mcer12/Nick2-Nixie-Clock/Resources/Nick2_in12_BOM.csv

ID | Name | Designator | Footprint | Quantity | Manufacturer Part | Manufacturer | Supplier | Supplier Part | Price
1 | 100nF | C1,C4,C5,C6,C7,C8,C9 | C0603 | 7 | CC0603KRX7R9BB104 | YAGEO | LCSC | C14663
2 | 10uF | C2 | C0603 | 1 | CL10A106KP8NNNC | SAMSUNG | LCSC | C19702 | 0.001
3 | 470uF | C10 | CAP-SMD_L7.3-W4.3-R-RD | 1 | T491D477M006AT | KEMET | LCSC | C122309 | 0.14
4 | ESP-WROOM-32 | ESP | WIFIM-SMD_ESP-WROOM-32 | 1 | ESP-WROOM-32 | ESPRESSIF | LCSC | C95209
5 | MF-PSMF110X-2 | F2 | F0805 | 1 | MF-PSMF110X-2 | BOURNS | LCSC | C89658 | 0.004
6 | AMS1117-3.3 | U6 | SOT-223-3_L6.5-W3.4-P2.30-LS7.0-BR | 1 | AMS1117-3.3 | AMS | LCSC | C6186 | 0.024
7 | U-D-M5DD-W-1 | USB1 | MICRO-USB-TH_MICRO-USB-A14 | 1 | U-D-M5DD-W-1 | HRO | LCSC | C145795 | 0.029
8 | WS2812B | LED1,LED2,LED3,LED4,LED5 | LED-SMD_4P-L5.0-W5.0-TL | 5 | WS2812B | Worldsemi | LCSC | C114585
9 | SW_IN-12B | NIX1,NIX2,NIX3,NIX4 | PK_IN-12B | 4
10 | MMBTA42_C118745 | NPN1,NPN2,NPN3,NPN4 | SOT-23-3_L2.9-W1.3-P1.90-LS2.4-BR | 4 | MMBTA42 | SEMTECH | LCSC | C118745 | 0.005
11 | MMBTA92-C118746 | PNP1,PNP2,PNP3,PNP4 | SOT-23-3_L2.9-W1.3-P1.90-LS2.4-BR | 4 | MMBTA92 | SEMTECH | LCSC | C118746 | 0.005
12 | 200K | R1,R3,R4,R5,R10,R11,R17,R18 | R1206 | 8 | TC0625D2003T5E | Uniroyal Elec | LCSC | C56009 | 0.007
13 | 4.7K | R2,R7,R8,R20 | R0603 | 4 | 0603WAF4701T5E | UniOhm | LCSC | C23162
14 | 470K | R6,R9,R12,R19 | R1206 | 4 | 1206W4F4703T5E | UniOhm | LCSC | C17997 | 0.001
15 | 1K | R13,R14 | R0603 | 2 | 0603WAF1001T5E | UniOhm | LCSC | C21190
16 | 10K | R15,R16,R31 | R0603 | 3 | 0603WAF1002T5E | UniOhm | LCSC | C25804
17 | 4.7K | R23,R24,R25,R26,R27,R28,R29,R30 | R1206 | 8 | 1206W4J0472T5E | UniOhm | LCSC | C26043
18 | MMBT3904-C20526 | T3,T4 | SOT-23-3_L2.9-W1.3-P1.90-LS2.4-BR | 2 | MMBT3904 | CJ | LCSC | C20526 | 0.002
19 | USBLC6-2SC6_C323793 | U1 | SOT-23-6_L2.9-W1.6-P0.95-LS2.8-BL | 1 | USBLC6-2SC6 | Yenji Elec | LCSC | C323793 | 0.013
20 | NCH8200HV | U2 | NCH8200HV | 1 | New SchematicLib |  | NixieClock | NCH8200HV
21 | 74141 Decoder | U3 | PDIP-16_L19.7-W6.6-P2.54-LS10.9-BL | 1 | CD4015BE | Texas Instruments |  | C201208 | 0.064
22 | CH340C | U5 | SOP-16_L10.0-W3.9-P1.27-LS6.0-BL | 1 | CH340C | WCH | LCSC | C84681 | 0.075
