mcer12/Nick2-Nixie-Clock/Resources/Nick2_in16_BOM.csv

ID | Name | Designator | Footprint | Quantity | Manufacturer Part | Manufacturer | Supplier | Supplier Part | Price
1 | 100nF | C1,C3,C4,C12,C13,C14,C15,C22 | C0603 | 8 | CC0603KRX7R9BB104 | YAGEO | LCSC | C14663
2 | 10uF | C2,C11 | C0603 | 2 | CL10A106KP8NNNC | SAMSUNG | LCSC | C19702 | 0.001
3 | 22uF | C6 | C0603 | 1 | CL10A226MQ8NRNC | SAMSUNG | LCSC | C59461 | 0.001
4 | 220pF | C7 | C0603 | 1 | CL10B221KB8NNNC | SAMSUNG | LCSC | C1603 | 0.001
5 | 1uF | C8 | C1812 | 1 | FS43X105K251EGG | Prosperity Dielectrics | LCSC | C381468 | 0.014
6 | 1uF | C9 | C0603 | 1 | CL10A105KB8NNNC | SAMSUNG | LCSC | C15849 | 0.001
7 | 220nF | C10 | C0603 | 1 | CL10B224KA8NNNC | SAMSUNG | LCSC | C21120 | 0.001
8 | MM1W91 | D2 | SOD-123FL_L2.7-W1.8-LS3.8-RD | 1 | MM1W91 | (MDD) Jiangsu Yutai Elec | LCSC | C364305 | 0.007
9 | DSF1G E1G | D3 | SOD-123_L2.8-W1.8-LS3.7-RD | 1 | DSF1G E1G | MDD | LCSC | C64910 | 0.002
10 | ESP-M2 | ESP | ESP-M2 | 1 | ESP-M2 | Ai-Thinker |  | C82895 | 0.364
11 | BSS138 | F2 | SOT-23-3_L2.9-W1.3-P1.90-LS2.4-BR | 1 | BSS138 | CJ | LCSC | C78284 | 0.004
12 | MF-PSMF110X-2 | F5 | F0805 | 1 | MF-PSMF110X-2 | BOURNS | LCSC | C89658 | 0.004
13 | AP7361-33E-13 | LDO1 | SOT-223_L6.5-W3.5-P2.30-LS7.0-BR | 1 | AP7361-33E-13 | DIODES | LCSC | C150719 | 0.023
14 | WS2812B | LED1,LED2,LED3,LED4,LED5,LED6,LED7,LED8,LED9,LED10,LED11,LED12,LED13,LED14 | LED-SMD_4P-L5.0-W5.0-TL | 14 | WS2812B | Worldsemi | LCSC | C114585
15 | IN-16 COPY | N1,N2,N3,N4,N5,N6 | IN-16 | 6 | IN-14
16 | ASDM30N65E | Q1 | DFN-8_L3.3-W3.3-P0.65-BL-EP | 1 | ASDM30N65E | Ascend(安森德) | LCSC | C2758222 | 0.052
17 | 20kΩ | R1,R2,R8,R9,R10,R11 | R1206 | 6 | 1206W4J0203T5E | UniOhm | LCSC | C25652
18 | 10K | R3,R4,R6 | R0603 | 3 | 0603WAF1002T5E | UniOhm | LCSC | C25804
19 | 1K | R5,R7,R25 | R0603 | 3 | 0603WAF1001T5E | UniOhm | LCSC | C21190
20 | 10MΩ | R12 | R1206 | 1 | HV06W4J0106T5E | UNI-ROYAL(Uniroyal Elec) | LCSC | C414767 | 0.003
21 | 470kΩ | R13 | R1210 | 1 | 1210W2J0474T5E | UNI-ROYAL(Uniroyal Elec) | LCSC | C621047 | 0.001
22 | 7.5kΩ | R15 | R0603 | 1 | 0603WAJ0752T5E | UniOhm | LCSC | C26006
23 | 499kΩ | R16 | R0603 | 1 | 0603WAF4993T5E | UniOhm | LCSC | C26751
24 | 5.1K | R18,R19 | R0603 | 2 | 0603WAF5101T5E | UniOhm | LCSC | C23186
25 | 10mΩ | R20 | R1206 | 1 | 1206W3F100MT5E | UNI-ROYAL(Uniroyal Elec) | LCSC | C473031 | 0.004
26 | 68kΩ | R21 | R0603 | 1 | 0603WAF6802T5E | UniOhm | LCSC | C23231
27 | MMBT3904-C20526 | T1,T2 | SOT-23-3_L2.9-W1.3-P1.90-LS2.4-BR | 2 | MMBT3904 | CJ | LCSC | C20526 | 0.002
28 | EE5.0 | T3 | EE5.0 | 1
29 | TTRN-060S-013 | T4 | TTRN-060S-013 | 1
30 | SN75468D | U1,U2,U3,U7,U8,U9,U10,U11,U12 | SOIC-16_L9.9-W3.9-P1.27-LS6.0-BL | 9 | SN75468D | TI(德州仪器) | LCSC | C2867467 | 0.097
31 | MAX668EUB+_C1530054 | U4 | UMAX-10_L3.0-W3.0-P0.50-LS4.9-BL | 1 | MAX668EUB+ | MAXIM(美信) | LCSC | C1530054 | 1.768
32 | 74HCT595PW-Q100,11 | U5,U13,U14,U15,U16,U17,U18,U19 | TSSOP-16_L5.0-W4.4-P0.65-LS6.4-BL | 8 | 74HCT595PW-Q100,11 | Nexperia | LCSC | C179330 | 0.052
33 | USBLC6-2SC6_C323793 | U6 | SOT-23-6_L2.9-W1.6-P0.95-LS2.8-BL | 1 | USBLC6-2SC6 | Yenji Elec | LCSC | C323793 | 0.013
34 | CH340C | U20 | SOP-16_L10.0-W3.9-P1.27-LS6.0-BL | 1 | CH340C | WCH | LCSC | C84681 | 0.075
35 | USB3.1C16PFSMT | USBC1 | USB-C-SMD_TYPE-C-USB-17 | 1 | - | LCSC | LCSC | C167321 | 0.055
