mcer12/Nick2-Nixie-Clock/Resources/Nick2_ZM1040_BOM.csv

ID | Name | Designator | Footprint | Quantity | Manufacturer Part | Manufacturer | Supplier | Supplier Part | Price
1 | 100nF | C6,C1,C3,C4,C12,C13,C14,C22 | C0603 | 8 | CC0603KRX7R9BB104 | YAGEO | LCSC | C14663
2 | 330Ω | R61 | R0603 | 1 | 0603WAF3300T5E | UniOhm | LCSC | C23138
3 | 1K | R41,R42,R43,R44,R45,R46,R47,R48,R49,R50,R51,R52,R53,R54,R55,R56,R57,R58,R59,R60,R11,R22,R23,R24,R25,R26,R27,R28,R29,R30,R31,R32,R33,R34,R35,R36,R37,R38,R39,R40,R5,R7,R10 | R0603 | 43 | 0603WAF1001T5E | UniOhm | LCSC | C21190
4 | 22uF | C15 | C1206 | 1 | CL31A226KPHNNNE | SAMSUNG(三星) | LCSC | C5672 | 0.004
5 | 10uF | C2,C11 | C0603 | 2 | CL10A106KP8NNNC | SAMSUNG | LCSC | C19702 | 0.001
6 | 1uF | C5,C8 | C1812 | 2 | FS43X105K251EGG | Prosperity Dielectrics | LCSC | C381468 | 0.015
7 | 220pF | C7 | C0603 | 1 | CL10B221KB8NNNC | SAMSUNG | LCSC | C1603 | 0.001
8 | 1uF | C9 | C0603 | 1 | CL10A105KB8NNNC | SAMSUNG | LCSC | C15849 | 0.001
9 | 220nF | C10 | C0603 | 1 | CL10B224KA8NNNC | SAMSUNG | LCSC | C21120 | 0.001
10 | DSF1G E1G | D3 | SOD-123_L2.8-W1.8-LS3.7-RD | 1 | DSF1G E1G | MDD | LCSC | C64910 | 0.002
11 | MF-PSMF110X-2 | F5 | F0805 | 1 | MF-PSMF110X-2 | BOURNS | LCSC | C89658 | 0.004
12 | AP7361-33E-13 | LDO1 | SOT-223_L6.5-W3.5-P2.30-LS7.0-BR | 1 | AP7361-33E-13 | DIODES | LCSC | C150719 | 0.026
13 | WS2812B-4020 | LED1 | LED-SMD_WS2812B-4020 | 1 | WS2812B-4020 | worldsemi | LCSC | C965557 | 0.018
14 | BSS131 H6327 | Q1,Q2,Q3,Q4,Q5,Q6,Q7,Q8,Q9,Q10,Q11,Q12,Q13,Q14,Q15,Q16,Q17,Q18,Q19,Q20,Q21,Q22,Q23,Q24,Q25,Q26,Q27,Q28,Q29,Q30,Q31,Q32,Q33,Q34,Q35,Q36,Q37,Q38,Q39,Q40,Q41 | PG-SOT23-3_L2.9-W1.3-P1.90-LS2.4-BR | 41 | BSS131 H6327 | Infineon Technologies | LCSC | C534599
15 | AP4085G | QT1 | PDFN-8_L5.8-W4.9-P1.27-LS6.1-BL | 1 | AP4085G | ALLPOWER(铨力) | LCSC | C2849572 | 0.034
16 | 10kΩ | R1,R2,R8,R9 | R1210 | 4 | 1210W2F1002T5E | UNI-ROYAL(厚声) | LCSC | C422430 | 0.002
17 | 10K | R3,R4,R6,R14 | R0603 | 4 | 0603WAF1002T5E | UniOhm | LCSC | C25804
18 | 10MΩ | R12 | R1206 | 1 | HV06W4J0106T5E | UNI-ROYAL(Uniroyal Elec) | LCSC | C414767 | 0.003
19 | 470kΩ | R13,R17 | R1210 | 2 | 1210W2F4703T5E | UNI-ROYAL(厚声) | LCSC | C422291 | 0.002
20 | 7.5kΩ | R15 | R0603 | 1 | 0603WAJ0752T5E | UniOhm | LCSC | C26006
21 | 499kΩ | R16 | R0603 | 1 | 0603WAF4993T5E | UniOhm | LCSC | C26751
22 | 5.1K | R18,R19 | R0603 | 2 | 0603WAF5101T5E | UniOhm | LCSC | C23186
23 | 10mΩ | R20 | R1206 | 1 | 1206W3F100MT5E | UNI-ROYAL(Uniroyal Elec) | LCSC | C473031 | 0.003
24 | 68kΩ | R21 | R0603 | 1 | 0603WAF6802T5E | UniOhm | LCSC | C23231
25 | MMBT3904-C20526 | T2,T3 | SOT-23-3_L2.9-W1.3-P1.90-LS2.4-BR | 2 | MMBT3904 | CJ | LCSC | C20526 | 0.002
26 | MAX668EUB+_C1530054 | U4 | UMAX-10_L3.0-W3.0-P0.50-LS4.9-BL | 1 | MAX668EUB+ | MAXIM(美信) | LCSC | C1530054 | 1.768
27 | 74HCT595PW-Q100,11 | U5,U13,U14,U15,U16 | TSSOP-16_L5.0-W4.4-P0.65-LS6.4-BL | 5 | 74HCT595PW-Q100,11 | Nexperia | LCSC | C179330 | 0.052
28 | USBLC6-2SC6_C323793 | U6 | SOT-23-6_L2.9-W1.6-P0.95-LS2.8-BL | 1 | USBLC6-2SC6 | Yenji Elec | LCSC | C323793 | 0.013
29 | Neon bulb | U8,U9 | NEON BULB | 2
30 | CH340C | U20 | SOP-16_L10.0-W3.9-P1.27-LS6.0-BL | 1 | CH340C | WCH | LCSC | C84681 | 0.076
31 | ZM1040 | N1,N2,N3,N4 | TESLA ZM1040 | 4
32 | ESP-12S | U2 | WIRELM-SMD_ESP-12S | 1 | ESP-12S | Ai-Thinker(安信可) | LCSC | C82898 | 0.387
33 | TYPE-C 16P CB0.8 073 | USB1 | USB-C-SMD_TYPE-C-16P-CB0.8-073 | 1 | TYPE-C 16P CB0.8 073 | SHOU HAN(首韩) | LCSC | C2906289 | 0.014
