mcer12/Nick2-Nixie-Clock/(threads)

Thread 1 (2023-03-08):

Enclosure model: -todo-

Tom-Neverwinter, 2023-03-08:
Does the vfd enclosure work as the tubes should be the same?

mcer12, 2023-03-08:
Sorry, I forgot to add the models... IN-16 is added now, but I suggest the ZM1040 as it looks beautiful! Will add the model later today. https://www.reddit.com/r/esp8266/comments/100mmwy/made_another_esp8266_nixie_clock_atomic_age/

mcer12, 2023-03-08:
Note that in the IN-16 model, only the smaller transformer will fit.

mcer12, 2023-03-09:
@Tom-Neverwinter added ZM1040 model to the readme. It's a little bit more complicated to assemble but I highly recommend it.

Closed 2023-03-09.

Thread 2 (2023-04-11):

Component Placement List files

llamaonaskateboard, 2023-04-11:
The README says _"Can be almost completely sourced from LCSC (except for the VFDs of course) and partially assembled using JLCPCB assembly service."_
It appears JLCPCB needs a _Component Placement List (CPL)_ file in order to do this, refer https://jlcpcb.com/help/article/46-Pick-%26-Place-File-for-PCB-Assembly
Are you able to provide these files?

llamaonaskateboard, 2023-04-11:
The IN-16 one

mcer12, 2023-05-01:
Sorry I totally forgot about this, added.

Closed 2023-05-01.

Thread 3 (2023-05-08):

IN16 - ESP-07S too big for PCB

kafisc1, 2023-05-08:
thank's for this great project. I'm trying to build the IN16 version. JLCPCB informed me, that the ESP-07S ist too big for the PCB design.
On LCSC the ESP-07S is listed with the a size of 16x17x3mm. But if you take a look in the datasheet it is listed with 18x20x3mm.

Would it be possible to use the Wireless-tag WT8266-S3 ESP-07S instead which has a size of 17x16x3mm?

Datasheet for Wireless-tag WT8266-S3 ESP-07S:
[https://datasheet.lcsc.com/lcsc/2001032014_Wireless-tag-WT8266-S3-ESP-07S_C477828.pdf](url)

Datasheet for Ai-Thinker ESP-07S:
[https://datasheet.lcsc.com/lcsc/1810131811_Ai-Thinker-ESP-07S_C82895.pdf](url)

Thaynk you in advance

kafisc1, 2023-05-08:
> No, only ESP-M2 or if you want to somehow install external antenna you can use ESP-M1. Also, the IN-16 version comes with a caveat of transformer choice. It's mentioned in the schematic, you can use the very tiny one but you will have to limit the brightness. If you use the larger trasnformer, this goes away but it won't fit in the enclosure. If you're not yet dead set on which one to make, I suggest the ZM1040.

Thank's for the reply.
I've ordered the Ai-Thinker ESP-07S from LCSC #C82895 and it's not fitting on the PCB. Maybe they changed the size a little bit?
On LCSC the ESP-07S is listed with the a size of 16x17x3mm. But if you take a look in the datasheet it is listed with 18x20x3mm.

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

Thank you in advance
kafisc

mcer12, 2023-05-08:
You need ESP-M2 or optionally ESP-M1, using a different module will not fit.

kafisc1, 2023-05-08:
Ok thanks. Then you maybe should adjust  the IN16 BOM.
The ESP-M2 withe the supplier part #C82895 is the ESP I've ordered.
The #C82895 from lcsc is the wrong ESP in the BOM list.

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

mcer12, 2023-05-08:
Thanks, it's a "user" footprint because lcsc doesn't have M2 modules for sale. Maybe someone who designed it used ESP-07 as a basis for the model. You should be able to source it on aliexpress.

kafisc1, 2023-05-09:
> Thanks, it's a "user" footprint from easyeda library because lcsc doesn't have M2 modules for sale. Maybe someone who designed it used ESP-07 as a basis for the model. You should be able to source it on aliexpress.

Thank you very much for your help.
I will close this issue.

Closed 2023-05-09.
