mcer12/Nick2-Nixie-Clock/Resources/Nick2_ZM1040_schematic.pdf

# ESP-12S EP 17

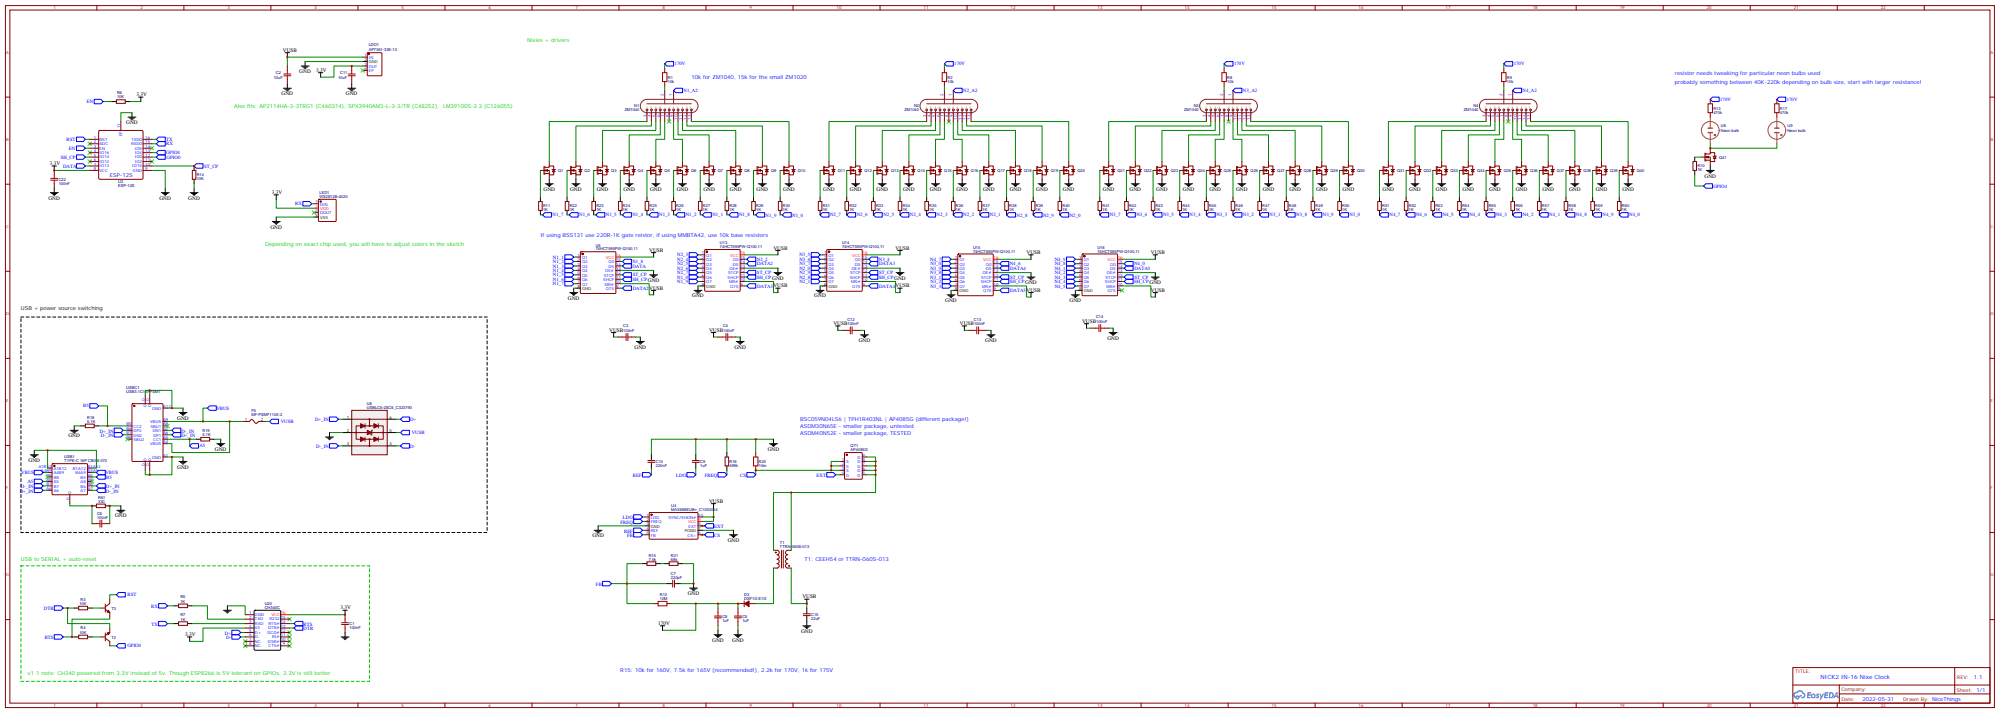
[picture p1: page 1]

resistor needs tweaking for particular neon bulbs used
probably something between 40K-220k depending on bulb size, start with larger resistance!

10k for ZM1040, 15k for the small ZM1020

If using BSS131 use 220R-1K gate reistor, if using MMBTA42, use 10k base resistors

Depending on exact chip used, you will have to adjust colors in the sketch

USB + power source switching

USB to SERIAL + auto-reset

v1.1 note: CH340 powered from 3.3V instead of 5v. Though ESP8266 is 5V tolerant on GPIOs, 3.3V is still better

R15: 10k for 160V, 7.5k for 165V (recommended!), 2.2k for 170V, 1k for 175V
