mcer12/Nick2-Nixie-Clock/Resources/Nick2_in12_schematic.pdf

# IO12 14 GND 15

IO0 25 IO4 26 IO16 27 IO17 28 IO5 29 IO18 30 IO19 31 NC 32 IO21 33 RXD0 34 TXD0 35 IO22 36 IO23 37 GND 38

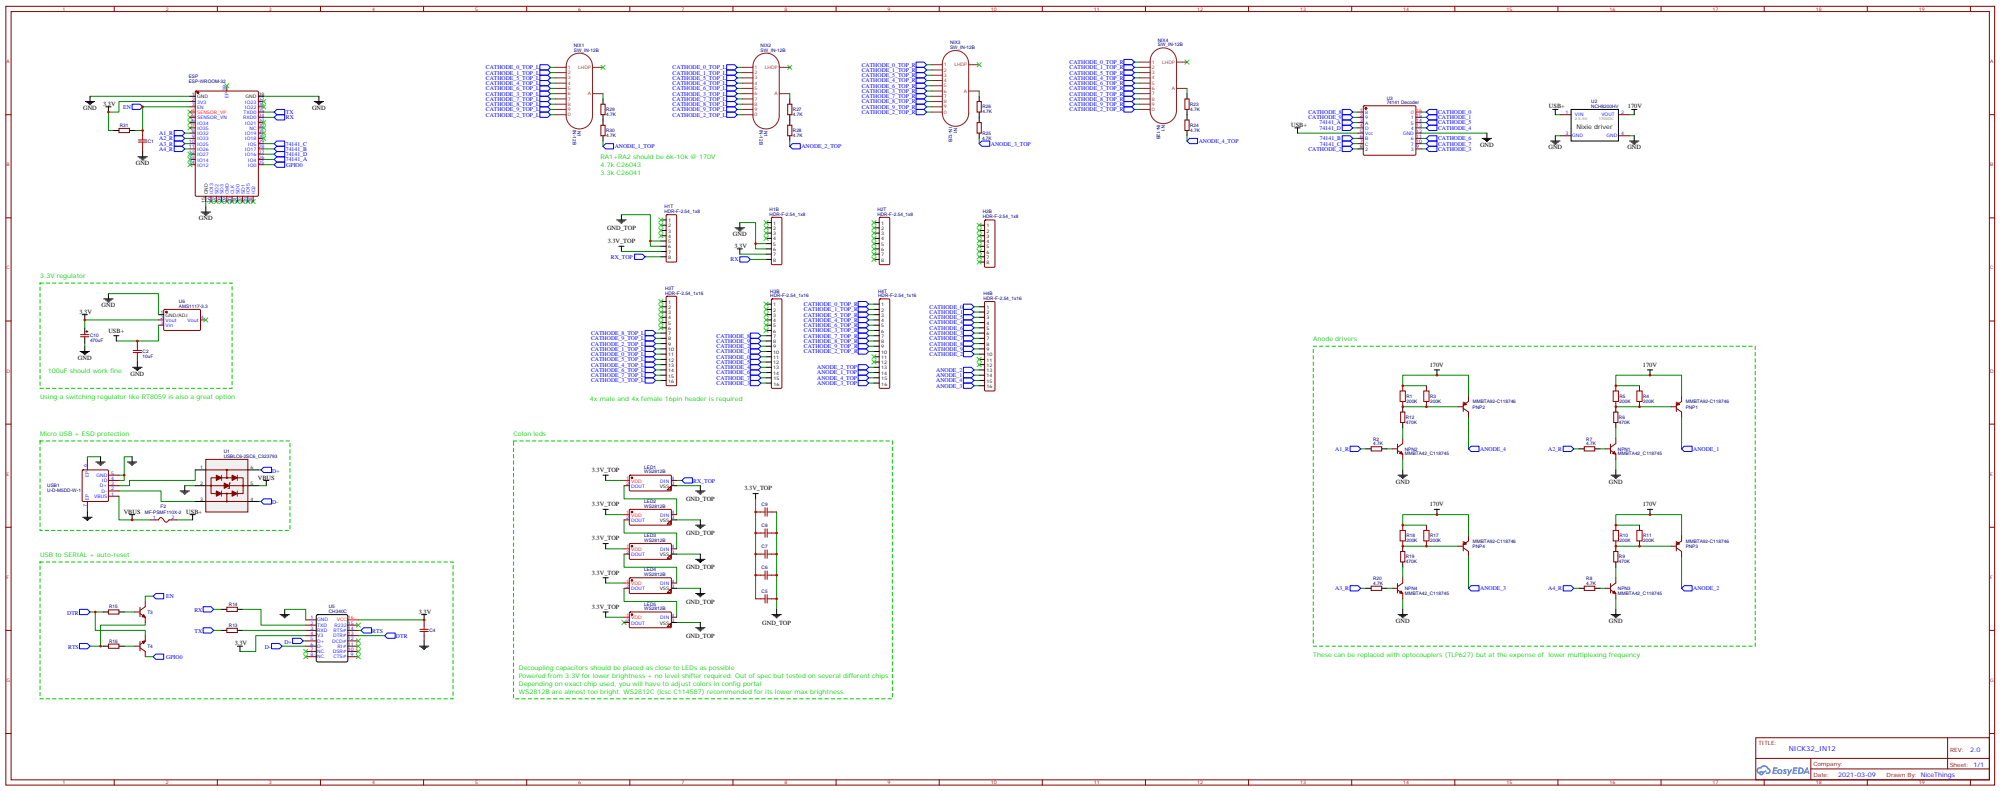
[picture p2: page 1]

Using a switching regulator like RT8059 is also a great option

4x male and 4x female 16pin header is required

Micro USB + ESD protection

USB to SERIAL + auto-reset

These can be replaced with optocouplers (TLP627) but at the expense of lower multiplexing frequency

Decoupling capacitors should be placed as close to LEDs as possible
Powered from 3.3V for lower brightness + no level shifter required. Out of spec but tested on several different chips
Depending on exact chip used, you will have to adjust colors in config portal
WS2812B are almost too bright. WS2812C (lcsc C114587) recommended for its lower max brightness.
