mcer12/Nick2-Nixie-Clock/Resources/Nick2_in16_schematic.pdf

## Nixies + drivers

## ESP-M2 is used for its tiny footprint

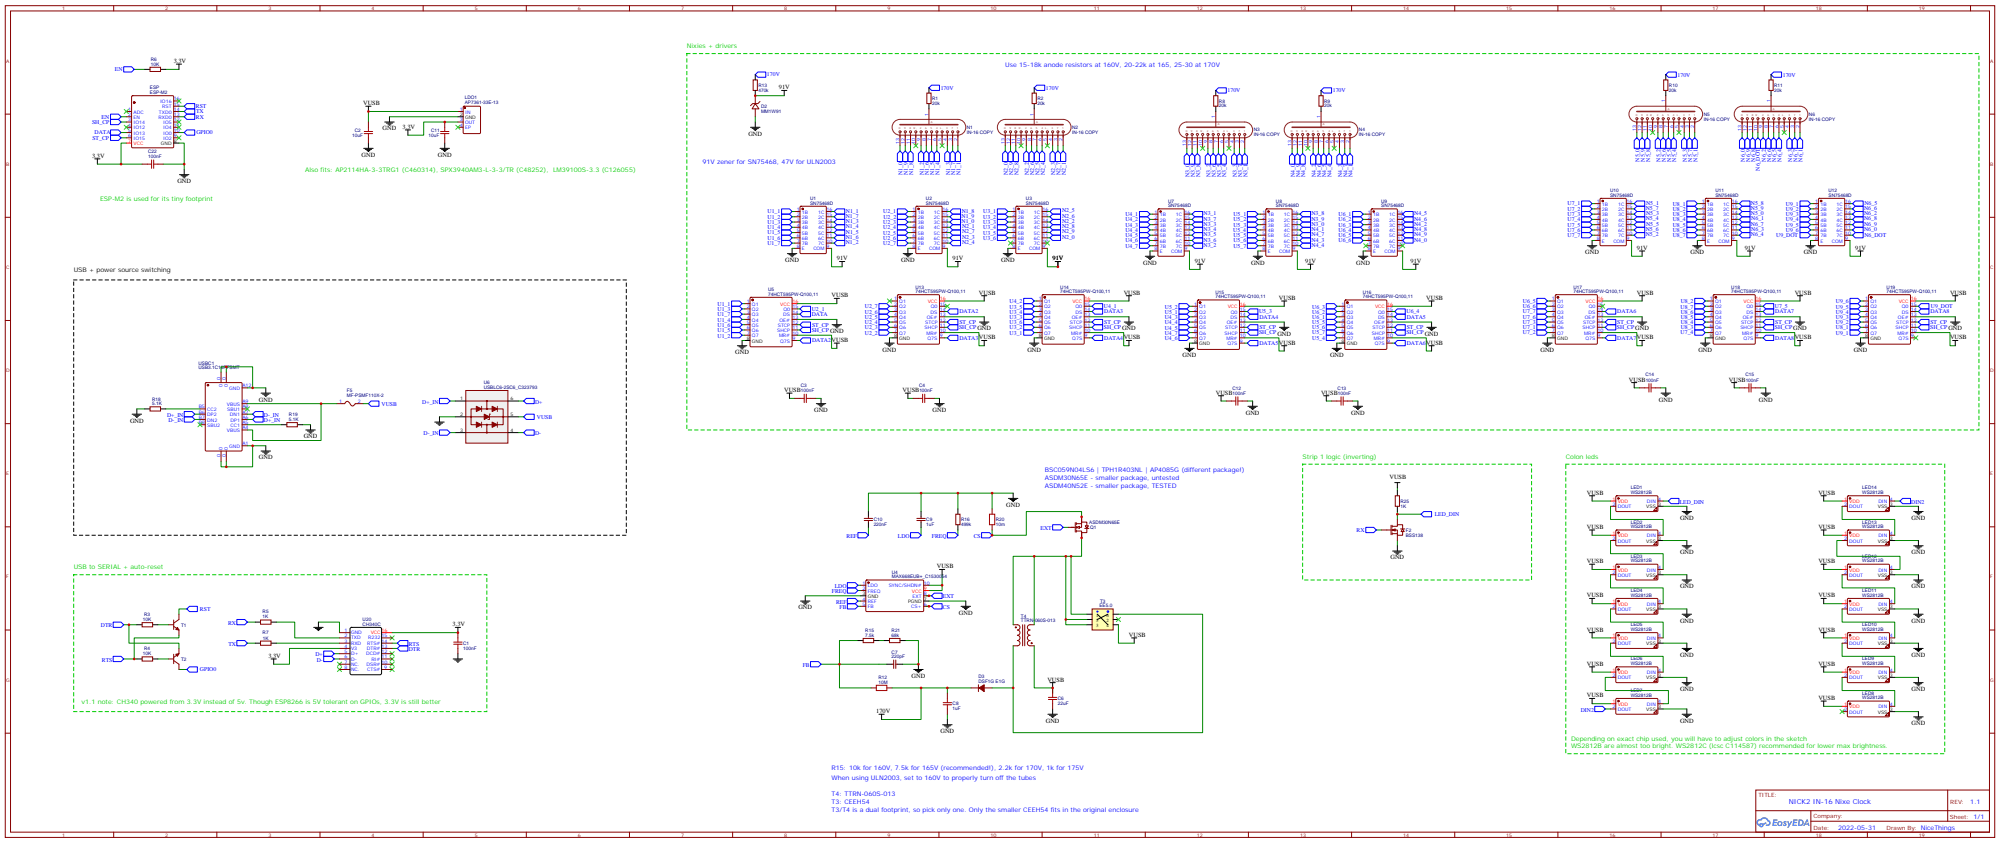
[picture p3: page 1]

Use 15-18k anode resistors at 160V, 20-22k at 165, 25-30 at 170V

USB + power source switching

USB to SERIAL + auto-reset

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

Depending on exact chip used, you will have to adjust colors in the sketch
WS2812B are almost too bright. WS2812C (lcsc C114587) recommended for lower max brightness.

R15: 10k for 160V, 7.5k for 165V (recommended!), 2.2k for 170V, 1k for 175V
When using ULN2003, set to 160V to properly turn off the tubes

T4: TTRN-060S-013
T3: CEEH54
T3/T4 is a dual footprint, so pick only one. Only the smaller CEEH54 fits in the original enclosure
