mcer12/Nick2-Nixie-Clock/(commit log)

2022-12-12 gerber, bom, schematic
    [Nick2_in16_BOM.csv]
2022-12-20 modified SPI library for ISR
2022-12-20 IN-12 version files
    [Nick2_in12_BOM.csv]
2023-01-06 Added ZM1040 version
    [Nick2_ZM1040_BOM.csv]
2023-01-10 set a little lower displaz refresh rate to prevent crashes
    [NICK2_FIRMWARE.ino]
2023-05-01 pick and place
    [Nick2_ZM1040_pickandplace.csv, Nick2_in16_pickandplace.csv]
